caglarmert/EE463-Hardware-Project/Simulations/Simulation results/Currents for bridge buck L C R.jpg

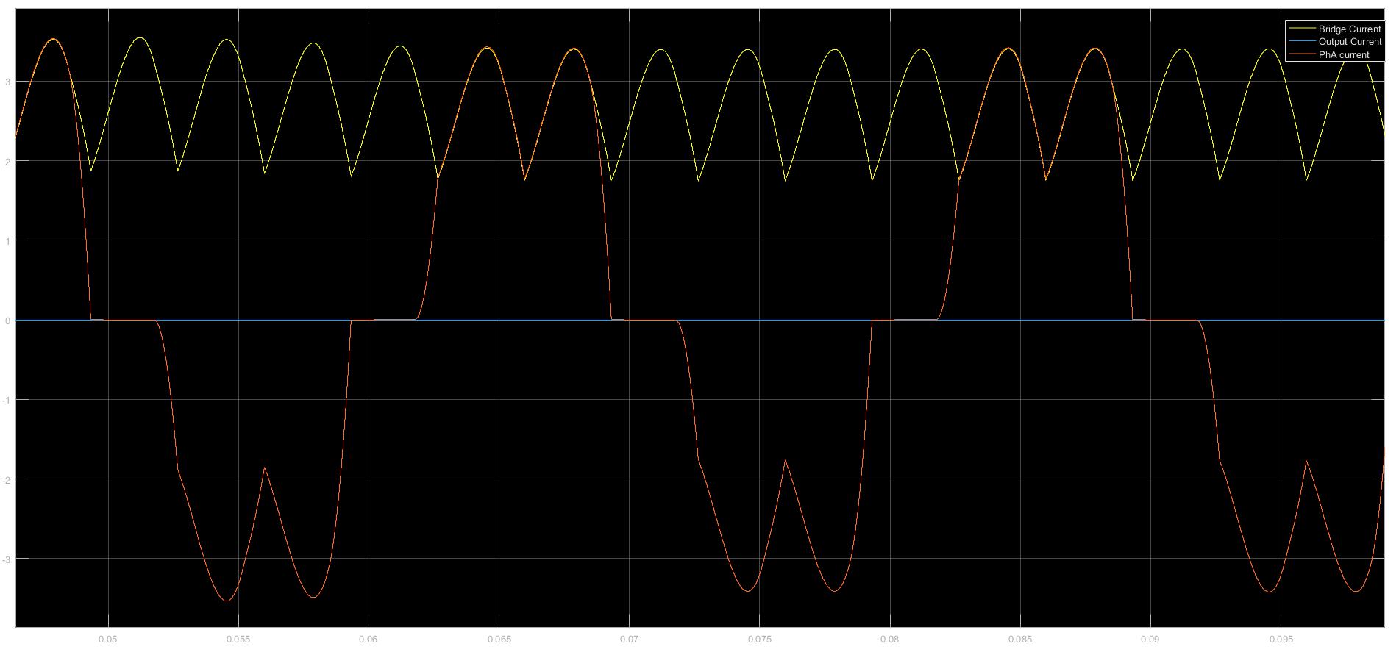
Simulations/Simulation results/Currents for bridge buck L C R.jpg
