caglarmert/EE463-Hardware-Project/Simulations/Simulation results/Currents for bridge C buck L R.jpg

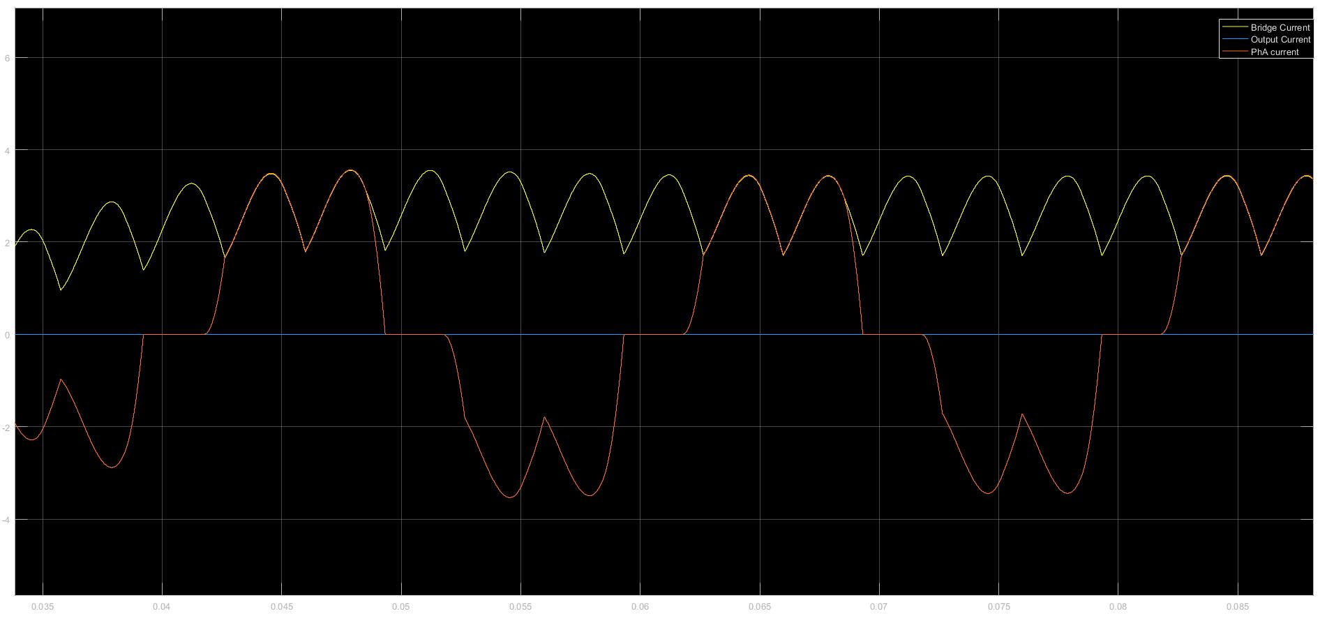
Simulations/Simulation results/Currents for bridge C buck L R.jpg
