caglarmert/EE463-Hardware-Project/Simulations/Simulation results/Voltages for bridge buck L C R.jpg

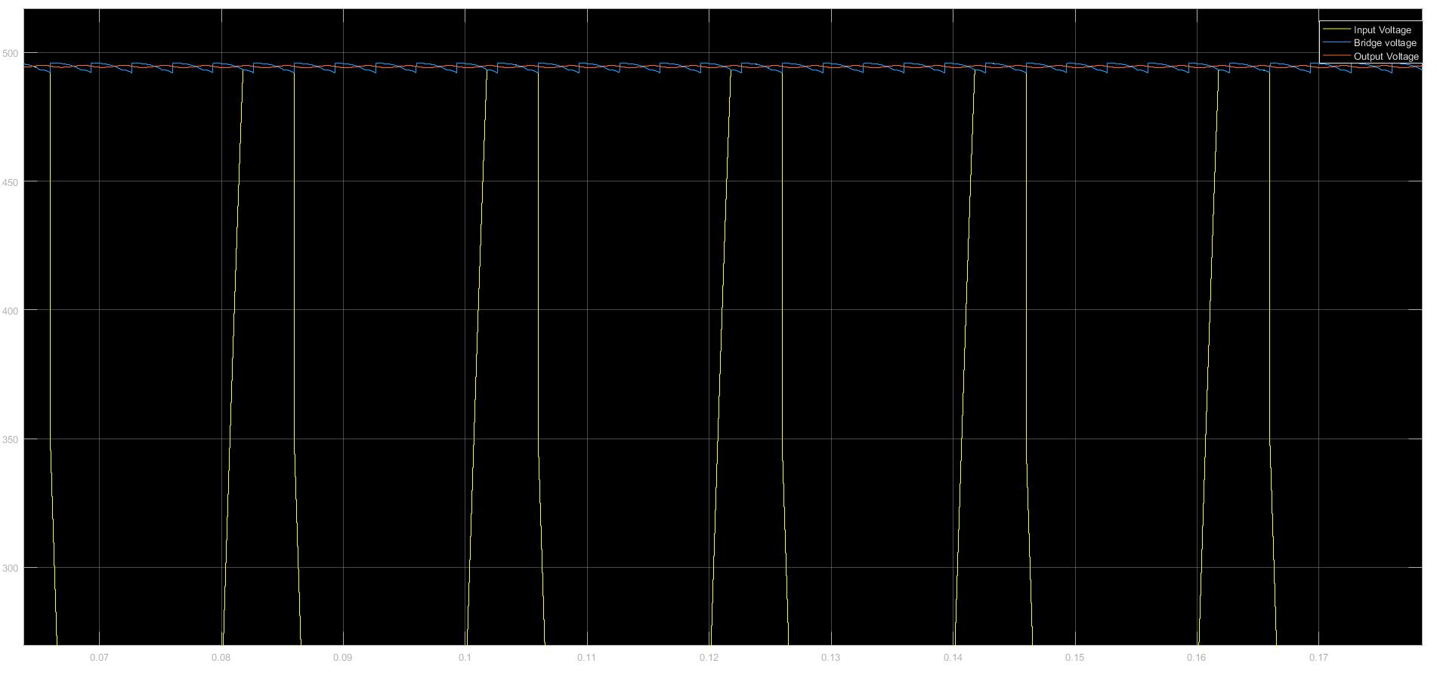
Simulations/Simulation results/Voltages for bridge buck L C R.jpg
