caglarmert/EE463-Hardware-Project/Simulations/Simulation results/Voltages for bridge buck L C.jpg

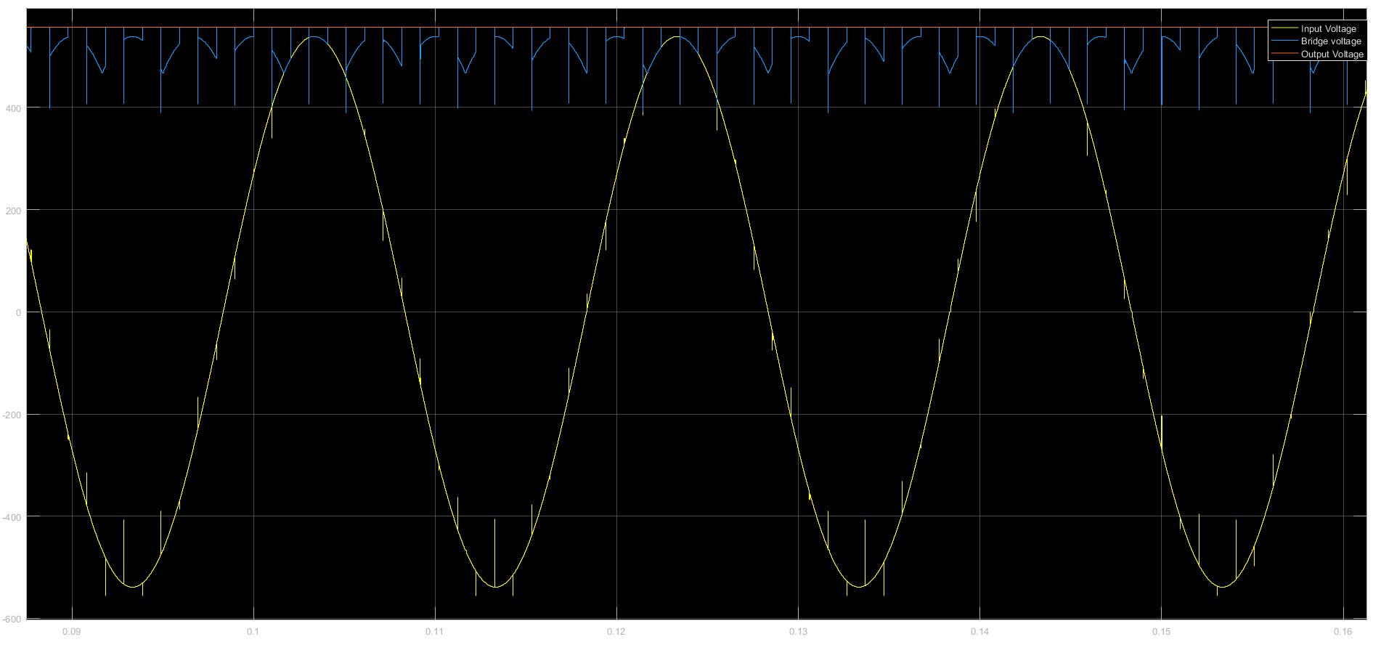
Simulations/Simulation results/Voltages for bridge buck L C.jpg
