caglarmert/EE463-Hardware-Project/Simulations/Simulation results/Voltages for bridge C buck L R.jpg

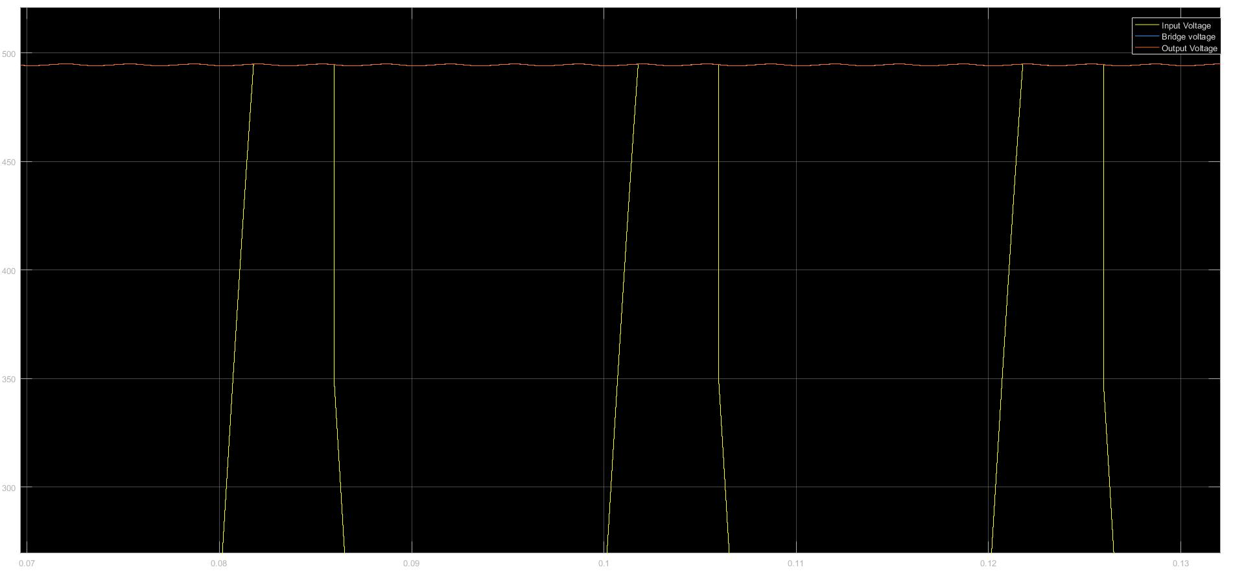
Simulations/Simulation results/Voltages for bridge C buck L R.jpg
