caglarmert/EE463-Hardware-Project/(commit log)

2018-01-06 Initial simulation
    Includes:
    AC/DC (three phase full bridge diode rectifier)
    DC/DC (buck converter)
    Motor
2018-01-06 Added measurements
    Disconnected motor to simulate ac/dc and dc/dc converters seperately
2018-01-19 Arduino sketch
2018-01-24 Replaced 1mF Capacitor in simulations
2018-01-24 Updated simulation file and added screenshots
    Replaced capacitor from output side to the output of buck converter. Now capacitor is DC-link capacitor to smooth out the DC voltage coming to the buck converter.
    Motor has inductive characteristic and its inertia will resist the voltage changes just like a capacitor so we dont need an output low pass filter. They were used to simulate motor characteristics.
    Screenshots of 3 configurations added
2018-01-26 report related simulation result buck converter
2018-01-27 Added Power Calculations
    Full load
    Half Load
    No Load
2018-01-27 Power calculations and Video
    +Voice synched with video
    +Sound levels adjusted
    todo:
    -Select appropriate music for the intro
2018-01-27 Report additions
    +Motor photos
    +Problem description imported from md
    +Conclusion imported from md
2018-01-28 arduino kodunu yazdım
2018-01-28 Report
    +Imported demo day experiences
    +Added problem definition
    +Improved power electronics description
